NuclearPhoenixx/Lightmeter/schematic_lightmeter.pdf

## RTC and Lightsensor

## Reset

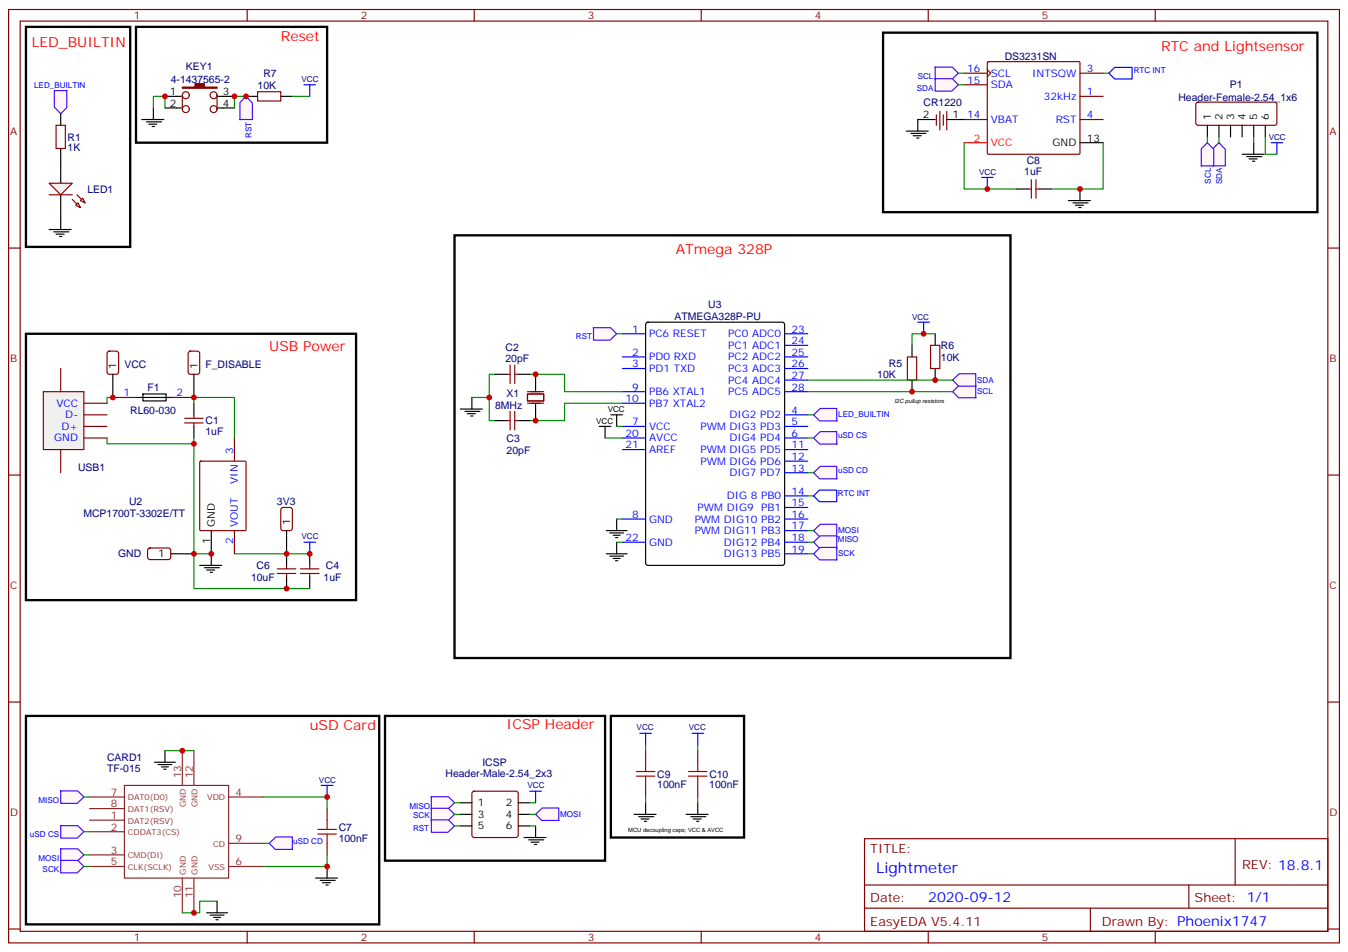
[picture p1: page 1]

MCU decoupling caps; VCC & AVCC
