NuclearPhoenixx/Lightmeter/lightmeter/lightmeter.ino

/*
   All-in-One Arduino-compatible Luxmeter.
   https://github.com/Phoenix1747/Lightmeter

   THIS PROJECT IS LICENSED UNDER GPL-3.0, FEEL FREE TO USE IT
   ACCORDING TO THE LICENSE. HAVE FUN!
*/
#include <SD.h>
#include <RTClib.h>
#include <Adafruit_TSL2591.h>

#include "Support.h" // All the needed extra functionality.

#define SD_CD 7 // Pin connected to the uSD card detect pin.
#define SD_CS 4 // Pin connected to the uSD card CS pin.
#define TSL2591_LUX_DF 650.0F // Lux cooefficient for calibration.

/* == SETTINGS == */
const String FILE_NAME = "DATA"; // Filename for the data file; 8 chars or less (FAT32 limit).
const String FILE_EXTENSION = "CSV"; // File extension for the data file; 3 chars or less (FAT32 limit).
const uint32_t MAX_FILESIZE = 4000000000; // Max filesize in bytes; defaults 4GB (FAT32 size limit).
const uint32_t M_INTERVAL = 5000; // Time between measurements [ms].
const bool MEASURE_TEMP = true; // Bool to log additional temperature info.
/* == == */

Adafruit_TSL2591 tsl(2591);
RTC_DS3231 rtc;

File dataFile; // Global variable that will hold the data file.
byte file_num = 0; // Global number of files written.
String file_path; // This will hold the file path globally.

/* == MCU SETUP == */
void setup()
{
  pinMode(LED_BUILTIN, OUTPUT); // Set builtin LED to output.
  pinMode(SD_CD, INPUT_PULLUP); // Setup the uSD card detect pin.

  if (!tsl.begin() || !SD.begin(SD_CS) || !rtc.begin() || rtc.lostPower()) // Initialize all the parts.
  {
    while (1) {
      support::ledFlash();
    }
  }

  tslSetup(); // Configure the TSL2591.

  file_path = FILE_NAME + "." + FILE_EXTENSION; // Setup the file path for the first time.
  dataFile = SD.open(file_path, FILE_WRITE); // Open that one data file.

  support::ledFlash(); // Test LED at startup and let sensor warm up.
}

/* == MAIN LOOP == */
void loop()
{
  if (digitalRead(SD_CD)) // Check for physically inserted uSD card.
  {
    support::ledFlash(); // Flash to indicate a problem.
    return;
  }

  String data;

  uint32_t timestamp = rtc.now().unixtime(); // Input current RTC unixtime.
  float lux = measureLux(); // Input measured lux value.
  data = String(timestamp) + "," + String(lux);

  if (MEASURE_TEMP)
  {
    float T = rtc.getTemperature(); // Input measured (RTC) temperature in °C for additional info.
    data += "," + String(T);
  }

  uint8_t data_size = sizeof(data); // Compute string size in bytes.
  uint32_t file_size = dataFile.size() + data_size; // Size of the updated save file in byte.

  // Check if the file size is bigger than the max set size; iterate until a valid file is found.
  while (file_size > MAX_FILESIZE)
  {
    dataFile.close(); // Close old file.

    file_num++; // Add 1 to the file number.
    file_path = FILE_NAME + file_num + "." + FILE_EXTENSION; // Update filename to include the file number.
    dataFile = SD.open(file_path, FILE_WRITE);

    file_size = dataFile.size() + data_size;
  }

  // If the data file is available write to it.
  if (dataFile)
  {
    dataFile.println(data); // Append the new data.
    dataFile.flush(); // Physically save the data, needs up to 3x the power though.
  }
  else // If no file is available flash an error.
  {
    support::ledFlash();
  }

  support::sleep(M_INTERVAL); // Sleep until the next measurement.
}

/* == TSL2591 SETUP == */
void tslSetup()
{
  tsl.setGain(TSL2591_GAIN_LOW); //TSL2591_GAIN_LOW, TSL2591_GAIN_MED, TSL2591_GAIN_HIGH, TSL2591_GAIN_MAX
  tsl.setTiming(TSL2591_INTEGRATIONTIME_100MS); //TSL2591_INTEGRATIONTIME_100MS, TSL2591_INTEGRATIONTIME_200MS, TSL2591_INTEGRATIONTIME_300MS, TSL2591_INTEGRATIONTIME_400MS, TSL2591_INTEGRATIONTIME_500MS, TSL2591_INTEGRATIONTIME_600MS
}

/* == TSL LUX COMPUTING == */
uint16_t _minBit = 65536 * 0.1; // Min and max lightsensor returns. Default +-10%.
uint16_t _maxBit = 65536 * 0.9;

float measureLux()
{
  uint32_t lum = tsl.getFullLuminosity();
  uint16_t ir, full = 0;
  ir = lum >> 16;
  full = lum & 0xFFFF;

  while (full > _maxBit || full < _minBit) // Check near overflow or 0.
  {
    autoRange(full);
    delay(800); // Sleep 800 ms to chill the sensor.

    lum = tsl.getFullLuminosity();
    ir = lum >> 16;
    full = lum & 0xFFFF;
  }

  return tsl.calculateLux(full, ir);
}

/* == AUTO SCALE LUX RANGE == */
void autoRange(uint16_t value) // Suggestions for this part greatly appreciated, it's *ugly*!
{
  if (value < _minBit) // Compute close to 0.
  {
    if (tsl.getTiming() < 5)
    {
      tsl.setTiming(tsl2591IntegrationTime_t(tsl.getTiming() + 1)); // Increase Timing if possible.
    }
    else if (tsl.getGain() < 3)
    {
      tsl.setGain(tsl2591Gain_t(tsl.getGain() + 1)); // Increase Gain if Timing is already max.
    }
    else
    {
      support::ledFlash(); // Something's not right here, ABORT.
    }
  }
  else if (value > _maxBit) // Compute close to overflow.
  {
    if (tsl.getGain() > 0)
    {
      tsl.setGain(tsl2591Gain_t(tsl.getGain() - 1)); // Decrease Gain if possible.
    }
    else if (tsl.getTiming() > 0)
    {
      tsl.setTiming(tsl2591IntegrationTime_t(tsl.getTiming() - 1)); // Decrease Timing if Gain is already min.
    }
    else
    {
      support::ledFlash(); // Something's not right here, ABORT.
    }
  }
}
