NuclearPhoenixx/Lightmeter/(commit log)

2018-04-30 lightsensor & rtc update
    - Update test file
    - Change default constructors for rtc and lightsensor parts
    - begin() function for lightsensor with auto-sensor-config
    - Change the lightsensor functions to make them more useful for this project
    - Add some todo comments
    - Change the class names for rtc and lightsensor parts
    - RTC part add some functions to the project for "redirection" to the DS3231 library
2018-04-30 Add LED signals +bootup firmware version blink
2018-05-08 A ton of fixes and improvements
    [lightmeter.ino]
2018-05-08 Update power consumption
2018-05-09 Efficiency improvements
    - Change function parameters to char instead of unsigned int
    - Use the power down mode between measurements for the TSL2591
2018-05-10 important fix to save EEPROM life
    [lightmeter.ino]
2018-05-10 fix clock sanity check
    [lightmeter.ino]
2018-05-10 update rtc error comment
    [lightmeter.ino]
2018-05-10 add power down sleep mode
2018-05-10 Implement power down sleep
2018-05-10 Update LED pin + misc code change
2018-05-27 add cr1220 battery to requirements
2018-05-28 Move sketch to appropriately named subfolder
    The Arduino IDE requires that a sketch be located in a folder of the same name. When opening a file that does not meet this sketch/folder name matching requirement the Arduino IDE presents a dialog:
    The file "lightsensor.ino" needs to be inside a sketch folder named "lightsensor".
    Create this folder, move the file, and continue?
    After clicking "OK" the Arduino IDE currently moves only the file lightsensor.ino to the new folder, leaving behind the other source files. This causes compilation of the sketch to fail:
    Lightmeter-master\lightmeter\lightmeter.ino:12:35: fatal error: rtc.h: No such file or directory
    The alternative solution you might b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
    [lightmeter.ino]
2018-06-07 Update for Arduino JSON 6.0.0-beta
2018-07-15 ditch FRAM buffering
    not a real benefit in regards of power or code efficiency
2018-08-10 fix uSD card detection
    [lightmeter.ino]
2018-08-28 fix led bug
2018-08-29 update power input
2018-12-08 Cleanup
    Important cleanup to remove all the old, ugly-as-hell code and get a bit back to the roots of the project. Will have to look into auto-gain and auto-timing some time in the future but will only add it if looking at it doesn't make me go blind.
    [Support.cpp, Support.h, lightmeter.ino]
2018-12-09 add calibration coefficient
2019-02-09 Fix status LED issue
    [Support.cpp, Support.h, lightmeter.ino]
2019-02-11 Try to fix scaling instabilities.
    [lightmeter.ino]
2019-04-22 add schematic
2019-04-22 update for schematic
2019-05-02 remove schematic
    See `dev` branch for the newest resources.
2019-08-31 change datatype to csv Other changes: - Update formatting - Add temperature logging optional only
2020-09-12 update schematic
    schematic was really ugly and old and some typos and i fixed all those things, now it is only ugly
2020-09-27 fix schematic link
2021-10-17 increase sensor read timeout
